anja-15/GutSe-A-Multi-Sensor-Imaging-Capsule-for-Targeted-Structural-GI-Diagnostics/README.md

# GutSe-A-Multi-Sensor-Imaging-Capsule-for-Targeted-Structural-GI-Diagnostics
