anja-15/GutSe-A-Multi-Sensor-Imaging-Capsule-for-Targeted-Structural-GI-Diagnostics/Camera.STL

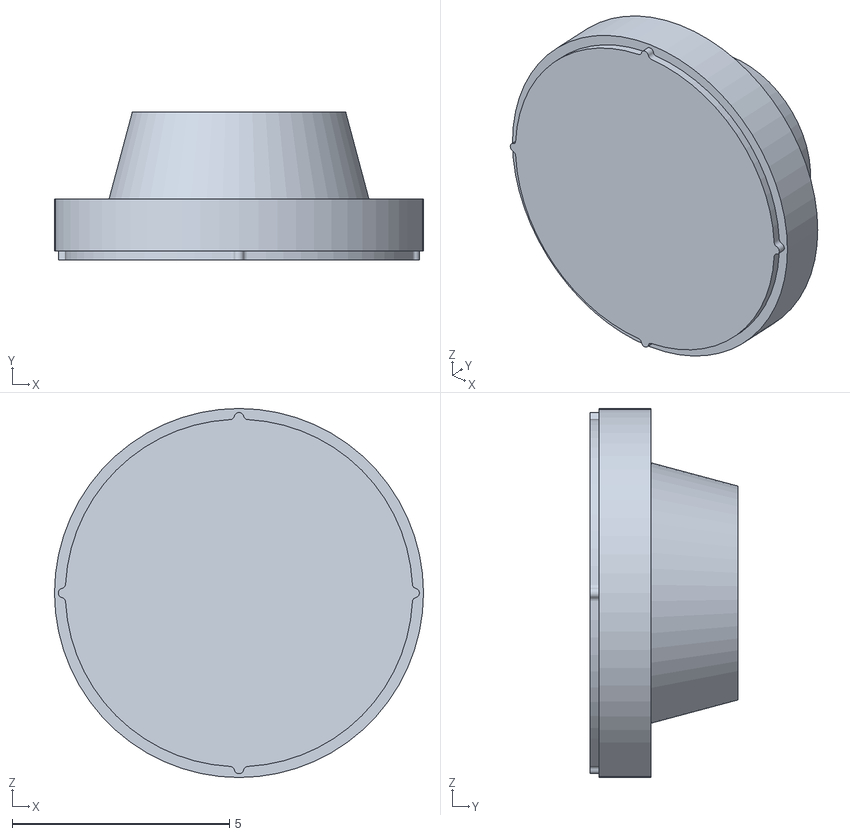
[picture p8: CAD file, 2026-03-12]
Camera.STL
8.50 x 3.40 x 8.50
