anja-15/GutSe-A-Multi-Sensor-Imaging-Capsule-for-Targeted-Structural-GI-Diagnostics/08 09 Camera Holder.STL

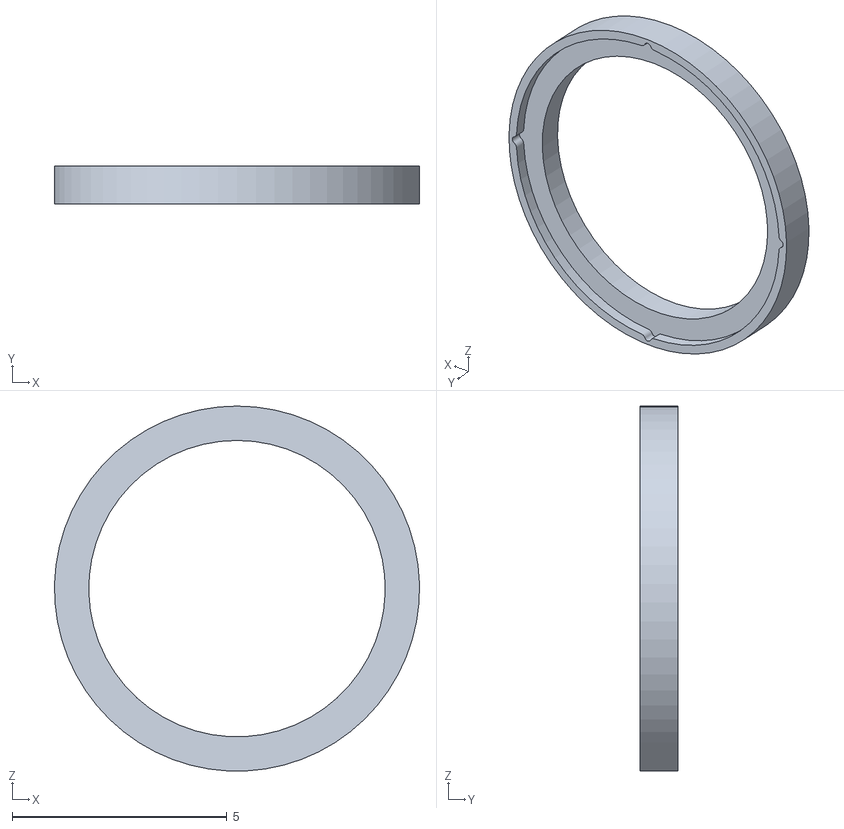
[picture p9: CAD file, 2026-03-12]
08 09 Camera Holder.STL
8.50 x 0.88 x 8.49
