anja-15/GutSe-A-Multi-Sensor-Imaging-Capsule-for-Targeted-Structural-GI-Diagnostics/PArt 01-Lens.STL

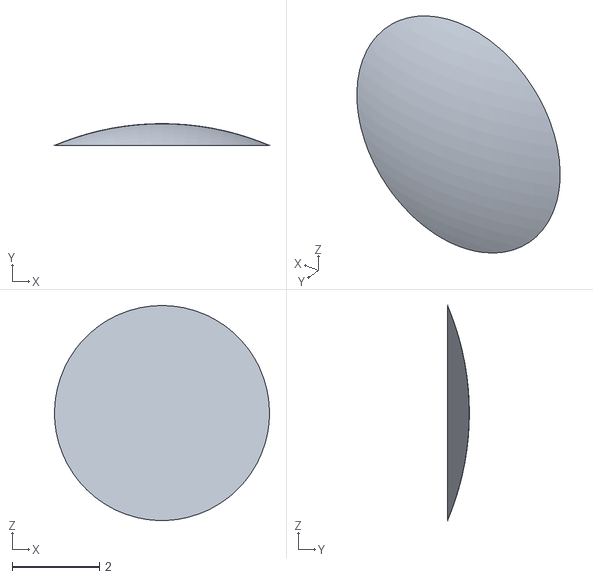
[picture p10: CAD file, 2026-03-12]
PArt 01-Lens.STL
4.93 x 0.5 x 4.93
