anja-15/GutSe-A-Multi-Sensor-Imaging-Capsule-for-Targeted-Structural-GI-Diagnostics/Battery Holder.STL

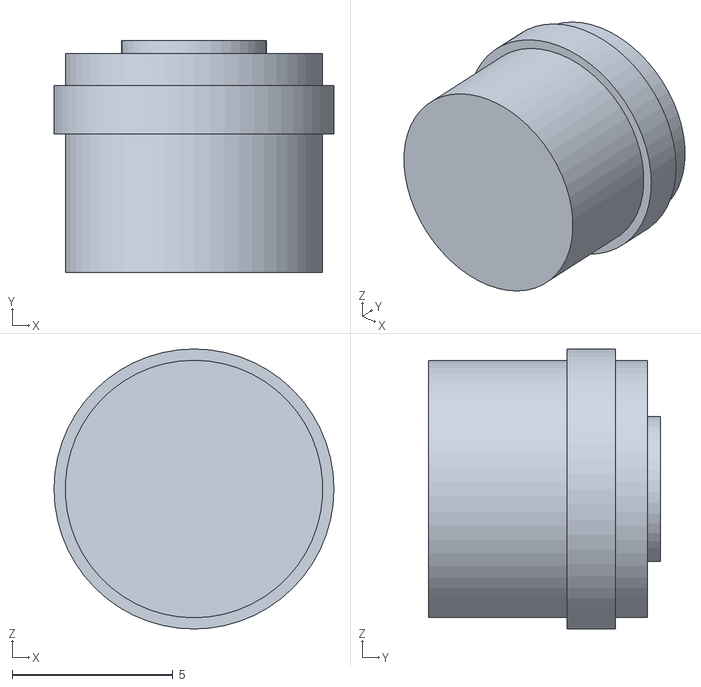
[picture p11: CAD file, 2026-03-12]
Battery Holder.STL
8.70 x 7.20 x 8.70
