anja-15/GutSe-A-Multi-Sensor-Imaging-Capsule-for-Targeted-Structural-GI-Diagnostics/Battery.STL

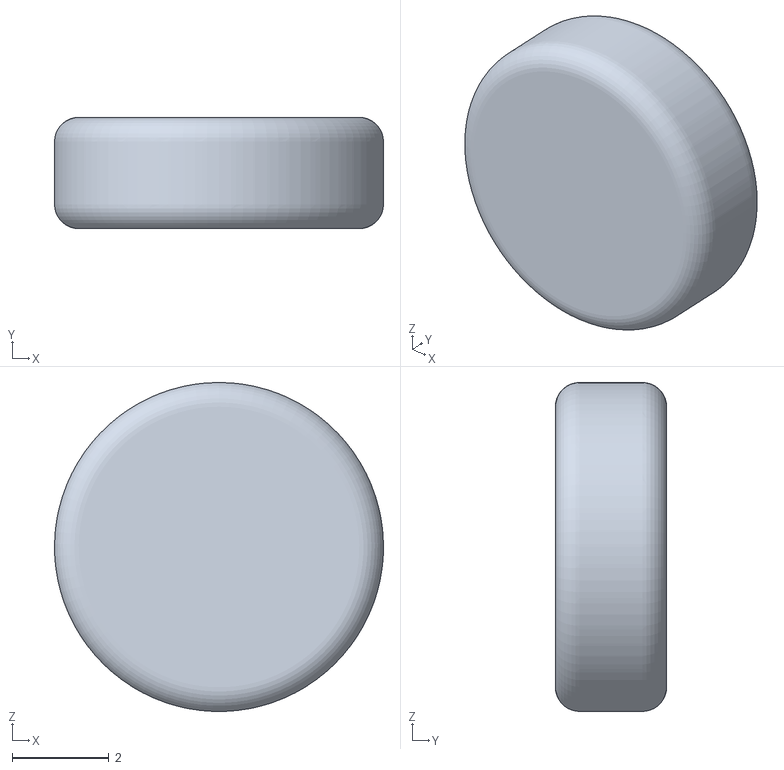
[picture p12: CAD file, 2026-03-12]
Battery.STL
6.80 x 2.30 x 6.80
