anja-15/GutSe-A-Multi-Sensor-Imaging-Capsule-for-Targeted-Structural-GI-Diagnostics/08 09 Top Cap.STL

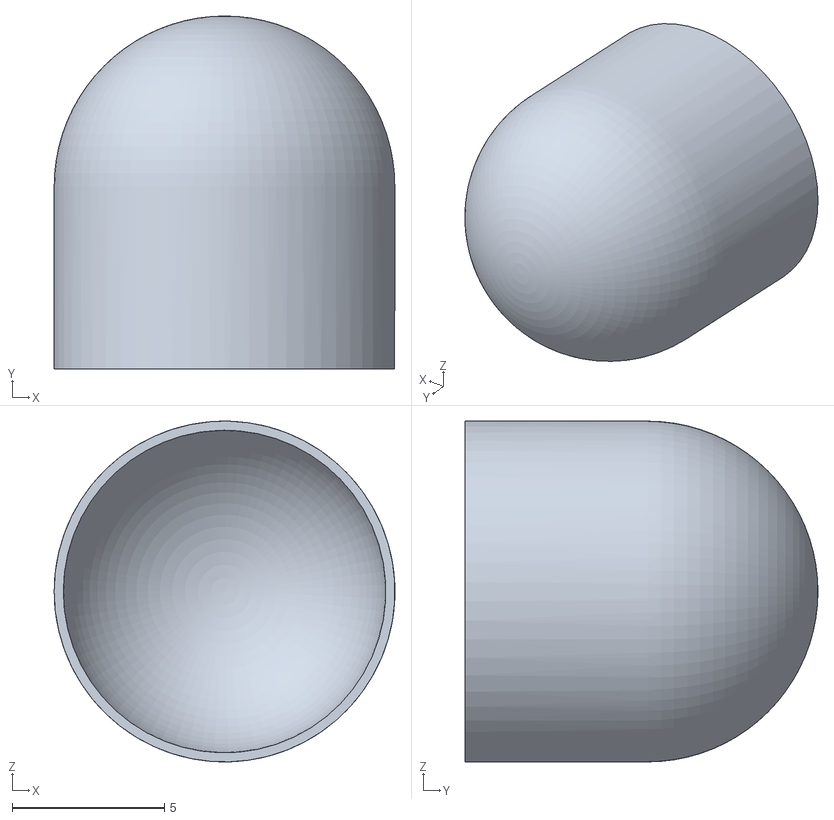
[picture p13: CAD file, 2026-03-12]
08 09 Top Cap.STL
11.2 x 11.6 x 11.2
