anja-15/GutSe-A-Multi-Sensor-Imaging-Capsule-for-Targeted-Structural-GI-Diagnostics/08 09 Bottom Cap.STL

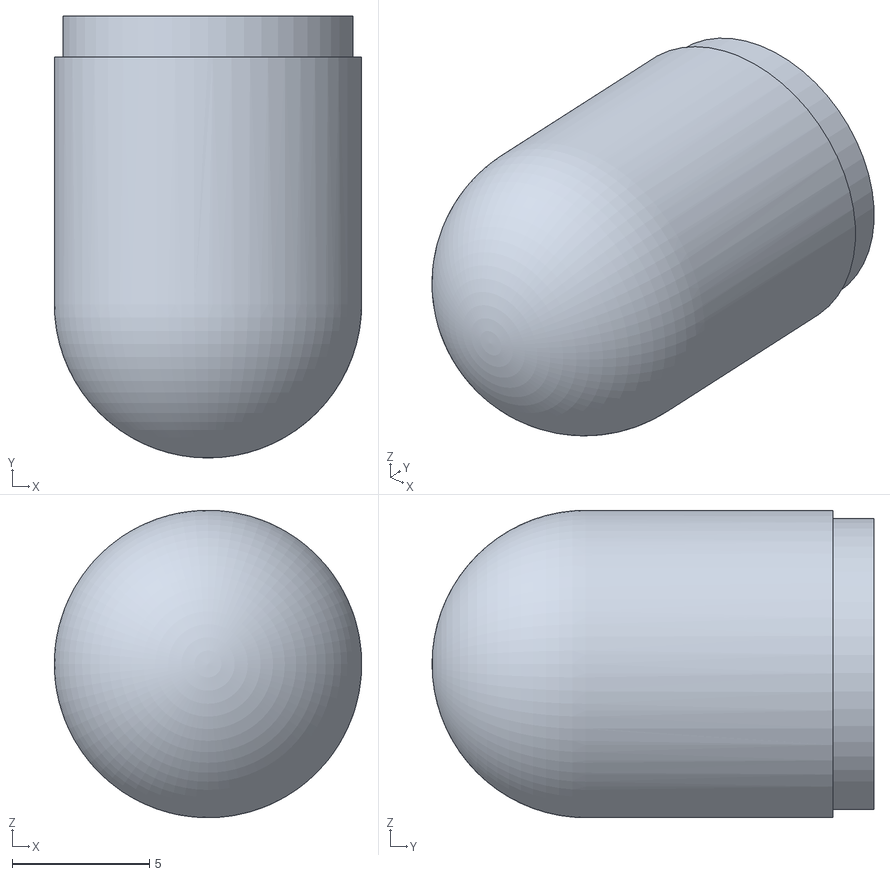
[picture p14: CAD file, 2026-03-12]
08 09 Bottom Cap.STL
11.2 x 16.1 x 11.2
