anja-15/GutSe-A-Multi-Sensor-Imaging-Capsule-for-Targeted-Structural-GI-Diagnostics/08 09 Holder .STL

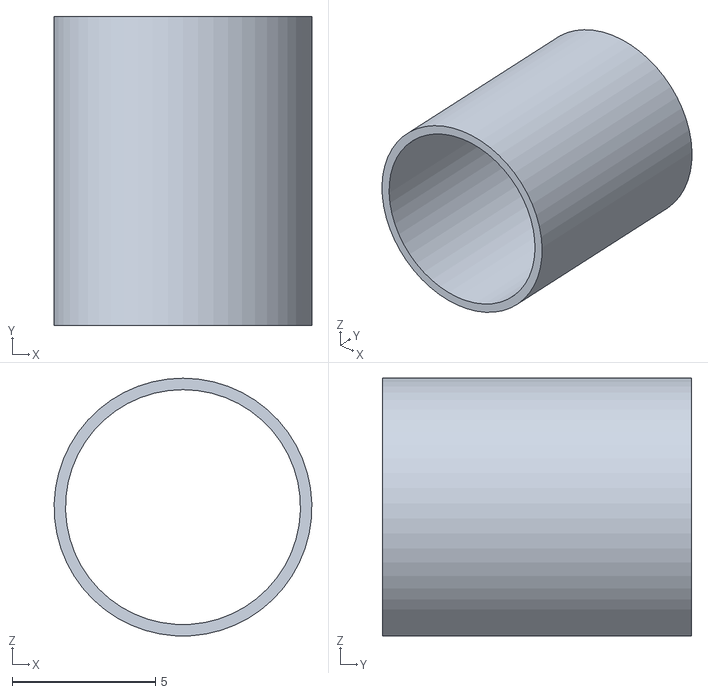
[picture p15: CAD file, 2026-03-12]
08 09 Holder .STL
9.00 x 10.8 x 8.99
