anja-15/GutSe-A-Multi-Sensor-Imaging-Capsule-for-Targeted-Structural-GI-Diagnostics/011.PDF

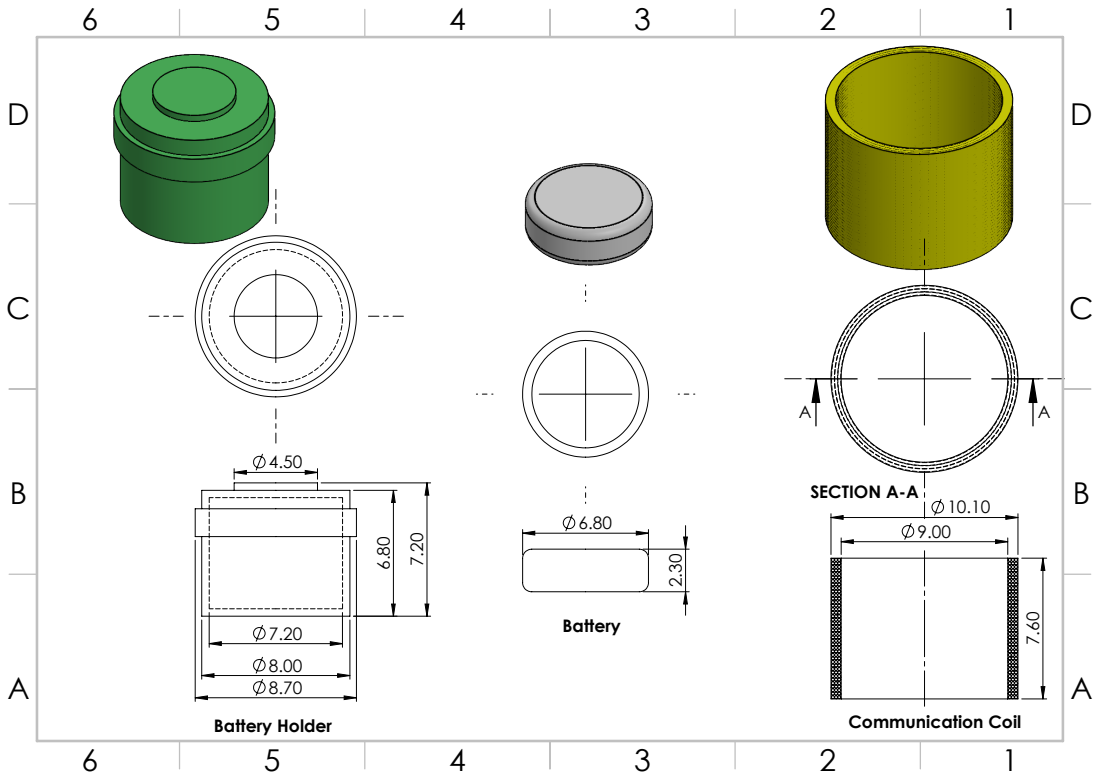
[picture p16: page 1]
SECTION A-A; Battery Holder; Communication Coil

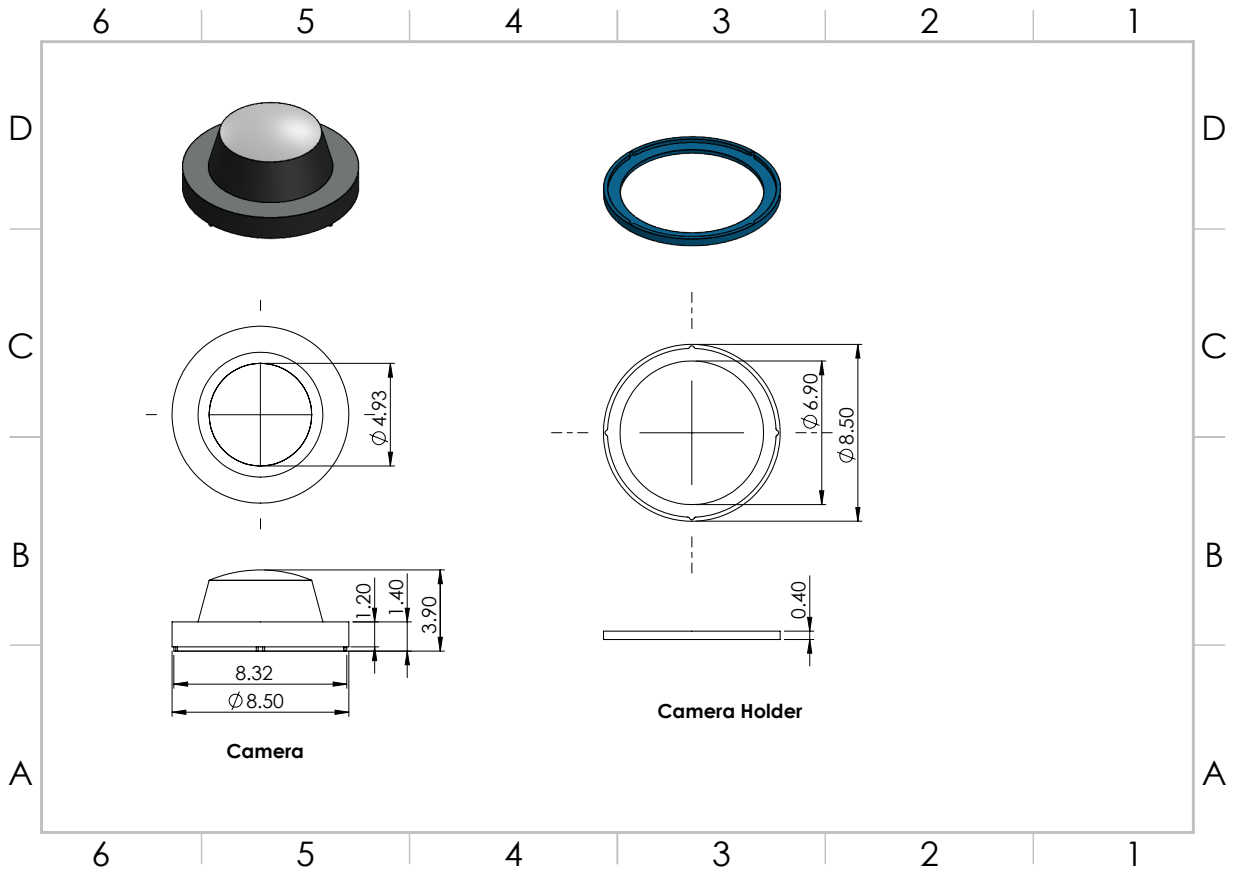
[picture p17: page 2]
Camera Holder

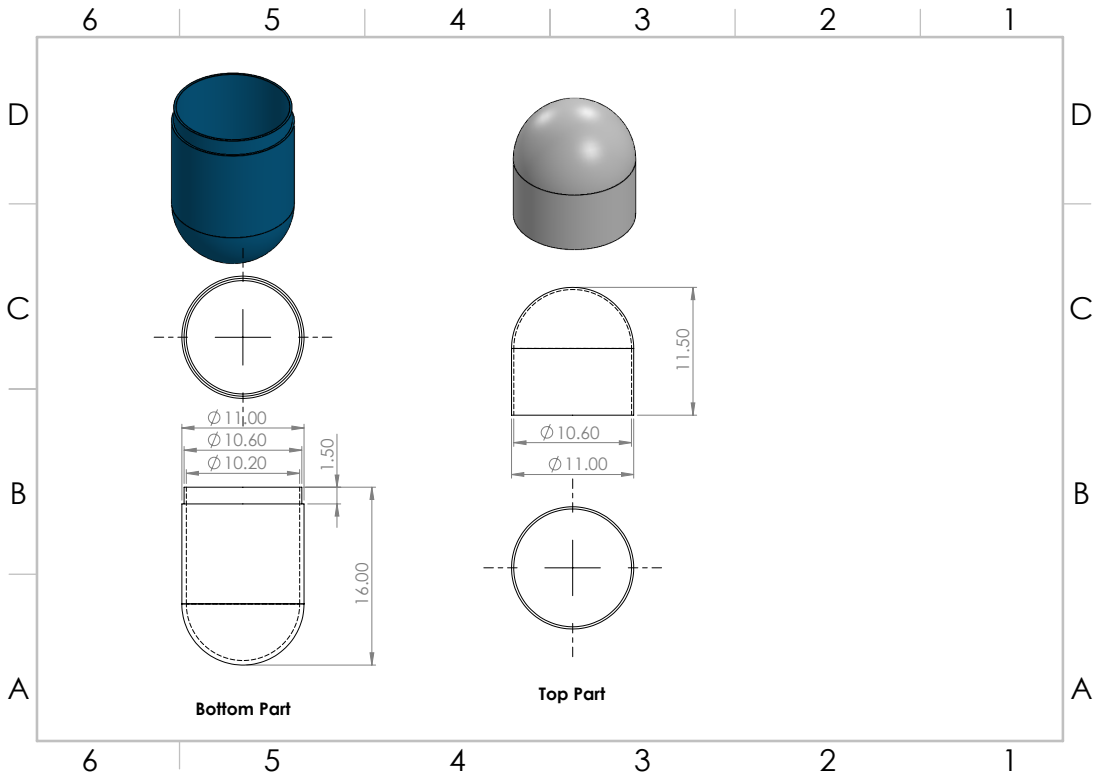
[picture p18: page 3]
Bottom Part; Top Part
