anja-15/GutSe-A-Multi-Sensor-Imaging-Capsule-for-Targeted-Structural-GI-Diagnostics/12.PDF

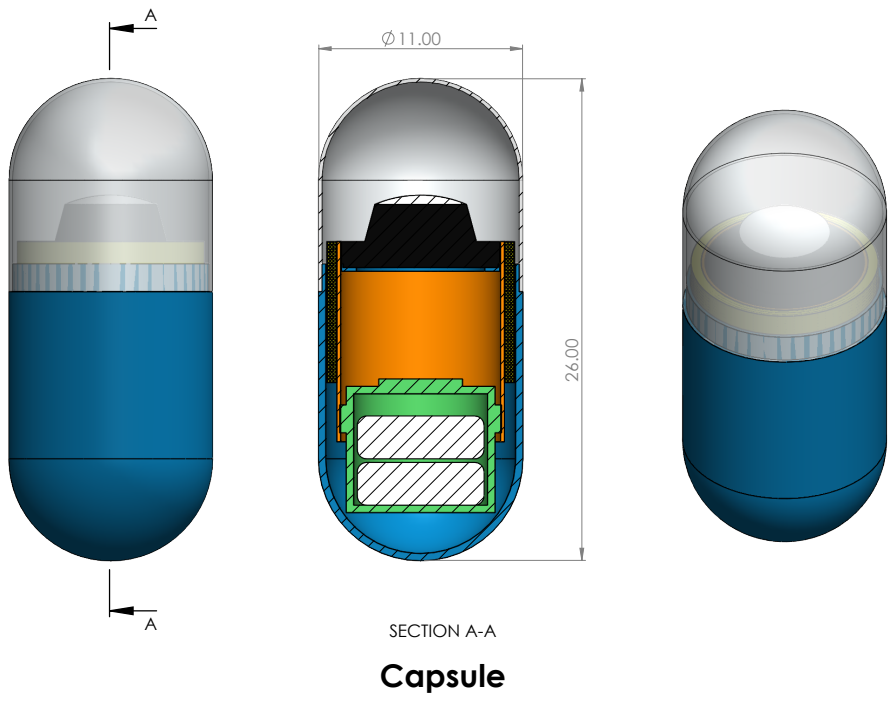
[picture p19: page 1]
SECTION A-A
